jorgep31415/ECE-3/README.md

# ECE-3
My final project, along with partner Betto Cerrillos, of UCLA course Electrical and Computer Engineering 3 taken in Fall 2018 with Prof. Briggs.

| Assignment | Score |
| --- | ----- |
| Difficulty & Success | 100 |
| Project Report | 91 |
